KimThanhNguyen1409/sEMG_Gesture_Recognition/BOM_Mua_Linh_Kien_TheGioiIC.xlsx

Sheet: BOM_Mua_Linh_Kien_TheGioiIC.csv
BẢNG DỰ TOÁN & DANH MỤC LINH KIỆN (BOM) - DỰ ÁN MẠCH THU NHẬN TÍN HIỆU SINH HỌC sEMG 3 KÊNH & ESP32-S
 | TỔNG CHỦNG LOẠI |  |  | SỐ LƯỢNG LINH KIỆN (MẠCH CẦN) |  |  | TỔNG CHI PHÍ DỰ TÍNH
STT | Nhóm | Mã hiển thị (Ref) | Tên linh kiện / Trị số | Đóng gói (Footprint) | Số lượng mạch cần | Số lượng nên mua | Đơn giá tham khảo (VNĐ/cái) | Thành tiền dự tính (VNĐ) | Từ khóa tìm kiếm trên Thegioiic.com | Ghi chú kỹ thuật khi chọn mua
1 | IC | U4 U5 U6 U7 U8 | MCP6004-I/SL | SOIC-14 (SOP-14) | 5 | 6 | 8000 |  | MCP6004-I/SL hoặc MCP6004 SOP14 | IC Op-Amp Quad 4 kênh Rail-to-Rail. Mua gói SOP-14 chân dán. (Nếu Thegioiic hết hàng thì Shopee bán vỉ 5 con ~35-50k).
2 | IC | U3 | ESP32-S (hoặc ESP32-WROOM-32) | SMD-38 (ESP32-WROOM-32) | 1 | 1 | 115000 |  | ESP32-S Ai-Thinker hoặc ESP32-WROOM-32 | QUAN TRỌNG: Mạch dùng footprint 38 chân (38 chân viền + 1 pad GND bụng). KHÔNG mua ESP32-S3 41 chân vì lệch footprint.
3 | IC | U1 | TP4056 | SOP-8-EP (ESOP-8) | 1 | 2 | 5700 |  | TP4056 SOP8 | IC sạc pin Li-Po 1A. Chọn loại chân dán SOP-8 có pad tản nhiệt dưới bụng.
4 | IC | U2 | AP2112K-3.3 | SOT-23-5 | 1 | 2 | 4500 |  | AP2112K-3.3 hoặc SOT-23-5 3.3V | LDO 3.3V 600mA cực thấp ồn. (Có thể thay bằng RT9193-33GB hoặc ME6211C33M5G cùng chân SOT-23-5).
5 | Tụ điện | C21 C22 C31 C32 C41 C42 | 100nF (0.1uF / 104) | SMD 1206 | 6 | 10 | 1200 |  | Tụ 1206 100nF hoặc Tụ 1206 0.1uF | QUAN TRỌNG: 6 tụ đầu vào CCIA. Ưu tiên chọn loại gốm C0G / NP0 sai số 5% hoặc 1% (chịu áp >= 25V) để giữ CMRR cân bằng.
6 | Tụ điện | C23 C24 C33 C34 C43 C44 | 2.2nF (mã 222) | SMD 0805 | 6 | 10 | 350 |  | Tụ 0805 2.2nF hoặc Tụ 0805 222 | Tụ hồi tiếp CCIA (G=45.45x). Ưu tiên C0G/NP0 hoặc X7R.
7 | Tụ điện | C16 C25 C35 C45 C63 C64 C65 C66 C67 | 100nF (0.1uF / 104) | SMD 0805 | 9 | 20 | 250 |  | Tụ 0805 100nF hoặc Tụ 0805 0.1uF | Tụ lọc HPF 19.4Hz, tụ lọc V3 của CH340C (C16) và 5 tụ bypass nguồn VDD của 5 con MCP6004.
8 | Tụ điện | C26 C36 C46 | 22nF (mã 223) | SMD 0805 | 3 | 10 | 350 |  | Tụ 0805 22nF hoặc Tụ 0805 223 | Tụ lọc thông thấp Sallen-Key Butterworth 490Hz (C1).
9 | Tụ điện | C27 C37 C47 | 10nF (mã 103) | SMD 0805 | 3 | 10 | 300 |  | Tụ 0805 10nF hoặc Tụ 0805 103 | Tụ lọc thông thấp Sallen-Key Butterworth 490Hz (C2).
10 | Tụ điện | C13 C14 C15 C62 | 1nF (mã 102) | SMD 0805 | 4 | 10 | 300 |  | Tụ 0805 1nF hoặc Tụ 0805 102 | Tụ tích phân DRL (C62) và 3 tụ lọc RC trước ngõ vào ADC của ESP32-S3.
11 | Tụ điện | C1 C2 C4 C10 C60 C61 C68 | 10uF (mã 106) | SMD 0805 | 7 | 15 | 650 |  | Tụ 0805 10uF | Tụ lọc nguồn VBUS, VBAT, +3V3 và lọc ổn định áp chuẩn VREF = 1.65V. Chọn tụ MLCC chịu áp >= 10V (10V/16V/25V).
12 | Tụ điện | C3 | 4.7uF | SMD 0805 | 1 | 5 | 550 |  | Tụ 0805 4.7uF | Tụ ngõ vào LDO AP2112K.
13 | Tụ điện | C12 | 1uF (mã 105) | SMD 0805 | 1 | 5 | 400 |  | Tụ 0805 1uF | Tụ định thì trễ chân EN (Reset) cho ESP32-S3.
14 | Tụ điện | C11 | 0.1uF (100nF) | SMD 0805 | 1 | Dùng chung tép 100nF | 0 |  | Tụ 0805 100nF | Tụ bypass nguồn gần ESP32-S3.
15 | Điện trở | R21 R22 R31 R32 R41 R42 | 150kΩ (mã 154) | SMD 0805 | 6 | 10 | 150 |  | Trở 0805 150k | Trở bảo vệ ngõ vào điện cực người dùng đạt chuẩn an toàn y tế IEC 60601-1 (giới hạn dòng rò < 25uA).
16 | Điện trở | R23 R24 R33 R34 R43 R44 R68 | 10MΩ (mã 106) | SMD 0805 | 7 | 10 | 250 |  | Trở 0805 10M | Trở phân cực ngõ vào Buffer về VREF và trở hồi tiếp DC mạch DRL.
17 | Điện trở | R25 R26 R35 R36 R45 R46 | 22MΩ (mã 226) | SMD 0805 | 6 | 10 | 300 |  | Trở 0805 22M | Trở hồi tiếp DC tầng CCIA định hình tần số cắt dưới 3.3Hz.
18 | Điện trở | R27 R37 R47 | 82kΩ (mã 823) | SMD 0805 | 3 | 10 | 150 |  | Trở 0805 82k | Trở định tần số cắt tầng lọc thông cao HPF 19.4Hz.
19 | Điện trở | R29 R39 R49 | 15kΩ (mã 153) | SMD 0805 | 3 | 10 | 150 |  | Trở 0805 15k | Trở hồi tiếp RF tầng HPF (độ lợi G = 2.5x).
20 | Điện trở | R28 R38 R48 R10 R11 | 10kΩ (mã 103) | SMD 0805 | 5 | 20 | 100 |  | Trở 0805 10k | Trở RG tầng HPF và trở pull-up chân EN, BOOT của ESP32-S3.
21 | Điện trở | R10 R11 R12 R13 R28 R38 R48 | 22kΩ (mã 223) | SMD 0805 | 7 | 20 | 150 |  | Trở 0805 22k | Trở RG tầng HPF, trở pull-up EN/IO0 và trở phân cực cực Base Q1/Q2 mạch Auto-Reset.
22 | Điện trở | R60 R61 R62 R63 R64 R65 R66 R67 | 100kΩ (mã 104) | SMD 0805 | 8 | 20 | 100 |  | Trở 0805 100k | Cầu chia áp VREF 1.65V và 6 trở lấy trung bình sai số chế độ chung vào mạch DRL.
23 | Điện trở | R69 | 390kΩ (mã 394) | SMD 0805 | 1 | 5 | 150 |  | Trở 0805 390k | Trở an toàn bảo vệ ngõ ra DRL nối về cơ thể người.
24 | Điện trở | R1 R2 | 5.1kΩ (mã 512) | SMD 0805 | 2 | 10 | 150 |  | Trở 0805 5.1k | Trở kéo CC1 CC2 cổng Type-C nhận diện nguồn cấp sạc 5V.
25 | Điện trở | R3 | 2.4kΩ (mã 242) | SMD 0805 | 1 | 5 | 150 |  | Trở 0805 2.4k | Trở cấu hình dòng sạc TP4056 (xấp xỉ 500mA an toàn cho pin Li-Po 500-1000mAh).
26 | Điện trở | R4 R5 R6 R17 | 1kΩ (mã 102) | SMD 0805 | 4 | 20 | 100 |  | Trở 0805 1k | Trở hạn dòng cho các đèn LED báo nguồn sạc và trạng thái.
27 | Điện trở | R14 R15 R16 | 100Ω (mã 101) | SMD 0805 | 3 | 10 | 150 |  | Trở 0805 100R | Trở lọc RC trước chân ADC IO4 IO5 IO6 của ESP32-S3.
28 | LED | D1 | Đỏ (RED) | LED 0805 SMD | 1 | 5 | 300 |  | LED 0805 Đỏ | LED báo trạng thái sạc pin (CHRG).
29 | LED | D2 | Xanh lá (GREEN) | LED 0805 SMD | 1 | 5 | 350 |  | LED 0805 Xanh lá | LED báo sạc đầy pin (STDBY).
30 | LED | D3 | Xanh dương (BLUE) | LED 0805 SMD | 1 | 5 | 400 |  | LED 0805 Xanh dương | LED báo nguồn hệ thống 3.3V (PWR).
31 | LED | D4 | Vàng hoặc Xanh | LED 0805 SMD | 1 | 5 | 350 |  | LED 0805 Vàng / Xanh | LED chỉ báo trạng thái chương trình nối chân IO48 ESP32-S3.
32 | Đầu nối | J1 | USB Type-C 16 chân | TYPE-C-31-M-12 SMD | 1 | 2 | 1800 |  | Cổng USB Type C 16 chân SMD | Cổng sạc và nạp code cho ESP32. Chân dán SMD có 4 chấu định vị xuyên lỗ.
33 | Đầu nối | J2 | JST-PH 2-pin đực thẳng | JST-PH-2P 2.0mm Vertical | 1 | 2 | 300 |  | Jack JST PH2.0 2P đực thẳng | Đầu cắm giắc pin Li-Po 3.7V tiêu chuẩn (khoảng cách chân 2.0mm).
34 | Đầu nối | J3 | Header 1x8P 2.54mm đực thẳng | PinHeader 1x08 P=2.54mm | 1 | 1 | 2500 |  | Hàng rào đực 1x40 2.54mm | Hàng rào cắm dây ra 3 cặp điện cực đo và cực DRL VREF.
35 | Nút nhấn | SW2 SW3 | Nút nhấn SMD 2 chân | SW_Push SMD (Alps SKRK 3.9x2.9mm) | 2 | 5 | 800 |  | Nút nhấn SMD 2 chân 3x4 hoặc 3x6 | Nút bấm Reset (EN) và nút Boot (IO0).
36 | Công tắc | SW1 | Công tắc gạt trượt SMD 3 chân | SW_SPDT_PCM12 | 1 | 2 | 1500 |  | Công tắc gạt SMD 3 chân hoặc PCM12 | Công tắc nguồn On/Off từ pin sang mạch.
37 | IC | U9 | CH340C | SOIC-16 (SOP-16) | 1 | 2 | 15000 |  | CH340C SOP-16 (Mã IC36480) | IC chuyển đổi USB sang UART tích hợp sẵn dao động nội 12MHz nạp code cho ESP32-S.
38 | Transistor | Q1 Q2 | MMBT3904 (hoặc S8050 / BC817) | SOT-23 | 2 | 5 | 300 |  | MMBT3904 SOT-23 hoặc BC817 SOT-23 | Transistor NPN dán SOT-23 cho mạch tự động nạp code DTR/RTS (Auto-Reset) điều khiển EN & IO0.
39 | Phụ kiện | Điện cực | Miếng dán điện cực tim/cơ y tế ECG/EMG (nút Snap) | Điện cực dán y tế dùng 1 lần | 7 | 1 | 50000 |  | Điện cực dán nút bấm Snap 3M / Contec hoặc Miếng dán điện cực tim | Bịch 50 miếng dán có sẵn gel dẫn điện (dùng 2 miếng/kênh x 3 kênh + 1 miếng DRL tham chiếu).
40 | Phụ kiện | Cáp nối | Bộ dây cáp kẹp điện cực nút bấm (Snap to Dupont / Jack 3.5) | Dây cáp y tế chuyên dụng | 7 | 1 | 70000 |  | Dây dẫn điện cực ECG Snap to Dupont hoặc Dây điện cực nút bấm 3.5mm | Dây nối từ các nút dán trên bắp tay về trạm cắm Header J3 trên bo mạch (bộ 10 sợi).
 |  |  | TỔNG CHI PHÍ LINH KIỆN DỰ TÍNH (ĐÃ BAO GỒM DỰ PHÒNG) |  |  |  |  |  |  | Ước tính khoảng 410.000 VNĐ cho toàn bộ linh kiện của bo mạch + điện cực & cáp kết nối.

Sheet: Don_Dat_Hang_TheGioiIC
ĐƠN ĐẶT HÀNG & PHIẾU SOẠN HÀNG LINH KIỆN (PURCHASE ORDER)
Dự án: Bo Mạch Đo Điện Sinh Học (sEMG) 3 Kênh & ESP32-S | Mã đơn: PO-TGIC-20261107 | Ngày: 13/11/2026
THÔNG TIN BÊN MUA (KHÁCH HÀNG) |  |  |  |  | THÔNG TIN ĐƠN VỊ CUNG CẤP (BÊN BÁN)
Người đặt: Mạc Quang Khải • Email: khaimac616@gmail.com |  |  |  |  | Nhà cung cấp: CÔNG TY TNHH THƯƠNG MẠI THẾ GIỚI IC
Mục đích: Đặt linh kiện gia công & hàn mẫu bo mạch thử nghiệm |  |  |  |  | Website: Thegioiic.com • Hotline: (028) 3896 8699 • Địa chỉ: TP. Thủ Đức, TP.HCM
 | TỔNG CHỦNG LOẠI |  |  | TỔNG SỐ LƯỢNG ĐẶT |  |  | TỔNG GIÁ TRỊ DỰ TÍNH
STT | Nhóm linh kiện | Tên linh kiện / Thông số kỹ thuật | Đóng gói (Footprint) | Số lượng đặt | ĐVT | Từ khóa tìm kiếm trên Thegioiic.com | Đơn giá dự kiến (VNĐ) | Thành tiền dự kiến (VNĐ) | Kiểm tra kho (Pick List)
1 | IC | MCP6004-I/SL (U4, U5, U6, U7, U8) - Op-Amp Quad 4 kênh Rail-to-Rail | SOIC-14 (SOP-14) | 6 | Cái | MCP6004-I/SL hoặc MCP6004 SOP14 | 8000 ₫ |  | FALSE
2 | IC | ESP32-S (U3) - Module Wi-Fi/BLE SMD 38 chân (Ai-Thinker hoặc ESP32-WROOM-32) | SMD-38 (ESP32-WROOM-32) | 1 | Cái | ESP32-S Ai-Thinker hoặc ESP32-WROOM-32 | 115000 ₫ |  | FALSE
3 | IC | TP4056 (U1) - IC sạc pin Li-Po 1A | SOP-8-EP (ESOP-8 có pad tản nhiệt) | 2 | Cái | TP4056 SOP8 | 5700 ₫ |  | FALSE
4 | IC | AP2112K-3.3 (U2) - LDO 3.3V 600mA Low-noise | SOT-23-5 | 2 | Cái | AP2112K-3.3 hoặc SOT-23-5 3.3V | 4500 ₫ |  | FALSE
5 | Tụ điện | 100nF (0.1uF / 104) - C0G/NP0 sai số thấp (C21, C22, C31, C32, C41, C42) | SMD 1206 | 10 | Cái | Tụ 1206 100nF hoặc Tụ 1206 0.1uF | 1200 ₫ |  | FALSE
6 | Tụ điện | 2.2nF (mã 222) - Tụ hồi tiếp CCIA C0G/X7R (C23, C24, C33, C34, C43, C44) | SMD 0805 | 10 | Cái | Tụ 0805 2.2nF hoặc Tụ 0805 222 | 350 ₫ |  | FALSE
7 | Tụ điện | 100nF (0.1uF / 104) 50V - Tụ lọc HPF & Bypass (C25, C35, C45, C63-C67) | SMD 0805 | 20 | Cái | Tụ 0805 100nF hoặc Tụ 0805 0.1uF | 250 ₫ |  | FALSE
8 | Tụ điện | 22nF (mã 223) - Tụ lọc Butterworth 490Hz (C26, C36, C46) | SMD 0805 | 10 | Cái | Tụ 0805 22nF hoặc Tụ 0805 223 | 350 ₫ |  | FALSE
9 | Tụ điện | 10nF (mã 103) - Tụ lọc Butterworth 490Hz (C27, C37, C47) | SMD 0805 | 10 | Cái | Tụ 0805 10nF hoặc Tụ 0805 103 | 300 ₫ |  | FALSE
10 | Tụ điện | 1nF (mã 102) - Tụ tích phân DRL & Lọc ADC (C13, C14, C15, C62) | SMD 0805 | 10 | Cái | Tụ 0805 1nF hoặc Tụ 0805 102 | 300 ₫ |  | FALSE
11 | Tụ điện | 10uF (mã 106) >= 10V - Lọc nguồn & Áp chuẩn VREF (C1, C2, C4, C10, C60, C61, C68) | SMD 0805 | 15 | Cái | Tụ 0805 10uF | 650 ₫ |  | FALSE
12 | Tụ điện | 4.7uF - Tụ ngõ vào LDO AP2112K (C3) | SMD 0805 | 5 | Cái | Tụ 0805 4.7uF | 550 ₫ |  | FALSE
13 | Tụ điện | 1uF (mã 105) - Tụ trễ chân Reset EN (C12) | SMD 0805 | 5 | Cái | Tụ 0805 1uF | 400 ₫ |  | FALSE
14 | Tụ điện | 0.1uF (100nF) - Tụ bypass gần ESP32-S3 (C11) | SMD 0805 | 0 | Cái | Tụ 0805 100nF (Dùng chung từ tép STT 7) | 0 ₫ |  | FALSE
15 | Điện trở | 150kΩ (mã 154) - Bảo vệ ngõ vào chuẩn y tế IEC 60601-1 (R21, R22, R31, R32, R41, R42) | SMD 0805 | 10 | Cái | Trở 0805 150k | 150 ₫ |  | FALSE
16 | Điện trở | 10MΩ (mã 106) - Phân cực ngõ vào & Hồi tiếp DRL (R23, R24, R33, R34, R43, R44, R68) | SMD 0805 | 10 | Cái | Trở 0805 10M | 250 ₫ |  | FALSE
17 | Điện trở | 22MΩ (mã 226) - Hồi tiếp DC tầng CCIA 3.3Hz (R25, R26, R35, R36, R45, R46) | SMD 0805 | 10 | Cái | Trở 0805 22M | 300 ₫ |  | FALSE
18 | Điện trở | 82kΩ (mã 823) - Định tần cắt HPF 19.4Hz (R27, R37, R47) | SMD 0805 | 10 | Cái | Trở 0805 82k | 150 ₫ |  | FALSE
19 | Điện trở | 15kΩ (mã 153) - Hồi tiếp RF tầng HPF G=2.5x (R29, R39, R49) | SMD 0805 | 10 | Cái | Trở 0805 15k | 150 ₫ |  | FALSE
20 | Điện trở | 10kΩ (mã 103) - Trở RG tầng HPF & Pull-up EN/BOOT (R28, R38, R48, R10, R11) | SMD 0805 | 20 | Cái | Trở 0805 10k | 100 ₫ |  | FALSE
21 | Điện trở | 22kΩ (mã 223) - Mạch lọc Butterworth 490Hz (R30, R40, R50, R51, R52, R53) | SMD 0805 | 10 | Cái | Trở 0805 22k | 150 ₫ |  | FALSE
22 | Điện trở | 100kΩ (mã 104) - Cầu chia áp VREF 1.65V & Mạch DRL (R60-R67) | SMD 0805 | 20 | Cái | Trở 0805 100k | 100 ₫ |  | FALSE
23 | Điện trở | 390kΩ (mã 394) - Trở an toàn ngõ ra DRL nối cơ thể (R69) | SMD 0805 | 5 | Cái | Trở 0805 390k | 150 ₫ |  | FALSE
24 | Điện trở | 5.1kΩ (mã 512) - Kéo chân CC1, CC2 cổng Type-C (R1, R2) | SMD 0805 | 10 | Cái | Trở 0805 5.1k | 150 ₫ |  | FALSE
25 | Điện trở | 2.4kΩ (mã 242) - Định dòng sạc 500mA cho TP4056 (R3) | SMD 0805 | 5 | Cái | Trở 0805 2.4k | 150 ₫ |  | FALSE
26 | Điện trở | 1kΩ (mã 102) - Hạn dòng cho các LED báo hiệu (R4, R5, R6, R17) | SMD 0805 | 20 | Cái | Trở 0805 1k | 100 ₫ |  | FALSE
27 | Điện trở | 100Ω (mã 101) - Mạch lọc RC ngõ vào ADC ESP32 (R14, R15, R16) | SMD 0805 | 10 | Cái | Trở 0805 100R | 150 ₫ |  | FALSE
28 | LED | Đỏ (RED) - Báo trạng thái sạc pin CHRG (D1) | LED 0805 SMD | 5 | Cái | LED 0805 Đỏ | 300 ₫ |  | FALSE
29 | LED | Xanh lá (GREEN) - Báo sạc đầy pin STDBY (D2) | LED 0805 SMD | 5 | Cái | LED 0805 Xanh lá | 350 ₫ |  | FALSE
30 | LED | Xanh dương (BLUE) - Báo nguồn hệ thống 3.3V PWR (D3) | LED 0805 SMD | 5 | Cái | LED 0805 Xanh dương | 400 ₫ |  | FALSE
31 | LED | Vàng hoặc Xanh - Chỉ báo trạng thái GPIO48 (D4) | LED 0805 SMD | 5 | Cái | LED 0805 Vàng / Xanh | 350 ₫ |  | FALSE
32 | Đầu nối | USB Type-C 16 chân SMD sạc & nạp code (J1) | TYPE-C-31-M-12 SMD | 2 | Cái | Cổng USB Type C 16 chân SMD | 1800 ₫ |  | FALSE
33 | Đầu nối | JST-PH 2-pin đực thẳng 2.0mm cắm pin Li-Po (J2) | JST-PH-2P 2.0mm Vertical | 2 | Cái | Jack JST PH2.0 2P đực thẳng | 300 ₫ |  | FALSE
34 | Đầu nối | Header 1x8P 2.54mm đực thẳng cắm điện cực (J3) | PinHeader 1x08 P=2.54mm | 1 | Cái | Hàng rào đực 1x40 2.54mm | 2500 ₫ |  | FALSE
35 | Nút nhấn | Nút nhấn SMD 2 chân Reset (EN) & Boot (IO0) (SW2, SW3) | SW_Push SMD (3.9x2.9mm / 3x4mm) | 5 | Cái | Nút nhấn SMD 2 chân 3x4 hoặc 3x6 | 800 ₫ |  | FALSE
36 | Công tắc | Công tắc gạt trượt SMD 3 chân nguồn On/Off (SW1) | SW_SPDT_PCM12 | 2 | Cái | Công tắc gạt SMD 3 chân hoặc PCM12 | 1500 ₫ |  | FALSE
37 | IC | CH340C (U9) - IC cầu chuyển đổi USB sang UART nạp code ESP32-S | SOIC-16 (SOP-16) | 2 | Cái | CH340C SOP-16 (Mã IC36480) | 15000 ₫ |  | FALSE
38 | Transistor | MMBT3904 (Q1, Q2) - Transistor NPN dán SOT-23 mạch Auto-Reset DTR/RTS | SOT-23 | 5 | Cái | MMBT3904 SOT-23 hoặc BC817 SOT-23 | 300 ₫ |  | FALSE
39 | Phụ kiện | Miếng dán điện cực y tế ECG/EMG có sẵn gel (bịch 50 cái) | Điện cực dán Snap Button | 1 | Bịch | Miếng dán điện cực tim ECG/EMG hoặc Nút dán điện cực Snap | 50000 ₫ |  | FALSE
40 | Phụ kiện | Dây cáp bấm điện cực nút Snap ra đầu Dupont cắm bo mạch (bộ 10 sợi) | Dây cáp y tế chuyên dụng | 1 | Bộ | Dây dẫn điện cực ECG Snap to Dupont hoặc Dây điện cực nút bấm 3.5mm | 70000 ₫ |  | FALSE
TỔNG CỘNG GIÁ TRỊ ĐƠN HÀNG DỰ TÍNH (VNĐ)

Sheet: Bang_Hoi_Gia_TheGioiIC
STT | Tên linh kiện / Thông số kỹ thuật | Đóng gói (Footprint) | Số lượng cần mua | Link sản phẩm (Thegioiic.com)
1 | MCP6004-I/SL hoặc MCP6004 SOP14 - Op-Amp Quad Rail-to-Rail | SOIC-14 (SOP-14) | 6 | MCP6004-I/SL IC OPAMP General Purpose Amplifier 4 Circuit 1MHz, 14-SOIC (https://www.thegioiic.com/mcp6004-i-sl-ic-opamp-general-purpose-amplifier-4-circuit-1mhz-14-soic)
~~2~~ | ~~ESP32-S (hoặc ESP32-WROOM-32 38 chân dán)~~ | ~~SMD-38 (ESP32-WROOM-32)~~ | ~~1~~ | ~~https://www.thegioiic.com/esp32-s-ai-thinker-module-wifi-bluetooth-4mb-flash~~ (https://www.thegioiic.com/esp32-s3-wroom-1-n16r8-module-wifi-bluetooth-16mb-flash-8mb-psram-2-4ghz)
3 | TP4056 - IC sạc pin Li-Po 1A | SOP-8-EP (ESOP-8 có pad tản nhiệt) | 2 | TP4056 IC Sạc Pin Li-Ion 1 Cell, 1 A, 4.2V 8-SOP (https://www.thegioiic.com/tp4056-ic-sac-pin-li-ion-1-cell-1-a-4-2v-8-sop)
4 | AP2112K-3.3 - LDO 3.3V 600mA Low-noise | SOT-23-5 | 2 | RT9193-33GB IC Ổn Áp 3.3V 300mA (https://www.thegioiic.com/rt9193-33gb-ic-on-ap-3-3v-300ma)
5 | 100nF (0.1uF / 104) - C0G/NP0 | SMD 1206 | 10 | Tụ Gốm 1206 100nF (0.1uF) 50V (https://www.thegioiic.com/tu-gom-1206-100nf-0-1uf-50v)
6 | 2.2nF (mã 222) - C0G/X7R | SMD 0805 | 10 | Tụ Gốm 0805 2.2nF 50V (https://www.thegioiic.com/tu-gom-0805-2-2nf-50v)
7 | 100nF (0.1uF / 104) 50V | SMD 0805 | 20 | Tụ Gốm 0805 100nF (0.1uF) 50V (https://www.thegioiic.com/tu-gom-0805-100nf-0-1uf-50v)
8 | 22nF (mã 223) | SMD 0805 | 10 | Tụ Gốm 0805 22nF 50V (https://www.thegioiic.com/tu-gom-0805-22nf-50v)
9 | 10nF (mã 103) | SMD 0805 | 10 | Tụ Gốm 0805 10nF 50V (https://www.thegioiic.com/tu-gom-0805-10nf-50v)
10 | 1nF (mã 102) | SMD 0805 | 10 | Tụ Gốm 0805 1nF 50V (https://www.thegioiic.com/tu-gom-0805-1nf-50v)
11 | 10uF (mã 106) >= 10V | SMD 0805 | 15 | Tụ Gốm 0805 10uF 25V (https://www.thegioiic.com/tu-gom-0805-10uf-25v)
12 | 4.7uF | SMD 0805 | 5 | Tụ Gốm 0805 4.7uF 50V (https://www.thegioiic.com/tu-gom-0805-4-7uf-50v)
13 | 1uF (mã 105) | SMD 0805 | 5 | Tụ Gốm 0805 1uF 50V (https://www.thegioiic.com/tu-gom-0805-1uf-50v)
14 | 0.1uF (100nF) | SMD 0805 | 0 | Tụ Gốm 0805 100nF (0.1uF) 50V (https://www.thegioiic.com/tu-gom-0805-100nf-0-1uf-50v)
15 | 150kΩ (mã 154) | SMD 0805 | 10 | Sách Điện Trở 0805 1% 170 Loại, Mỗi Loại 50 Con, Từ 0-10 MOhm (https://www.thegioiic.com/sach-dien-tro-0805-1-170-loai-moi-loai-50-con-tu-0-10-mohm)
16 | 10MΩ (mã 106) | SMD 0805 | 10 | Sách Điện Trở 0805 1% 170 Loại, Mỗi Loại 50 Con, Từ 0-10 MOhm (https://www.thegioiic.com/sach-dien-tro-0805-1-170-loai-moi-loai-50-con-tu-0-10-mohm)
17 | 22MΩ (mã 226) | SMD 0805 | 10 | Điện Trở Dán SMD (https://www.thegioiic.com/san-pham/dien-tro-dan-smd)
18 | 82kΩ (mã 823) | SMD 0805 | 10 | Sách Điện Trở 0805 1% 170 Loại, Mỗi Loại 50 Con, Từ 0-10 MOhm (https://www.thegioiic.com/sach-dien-tro-0805-1-170-loai-moi-loai-50-con-tu-0-10-mohm)
19 | 15kΩ (mã 153) | SMD 0805 | 10 | Điện Trở 12 KOhm 0805 1% (https://www.thegioiic.com/dien-tro-12-kohm-0805-1-)
20 | 10kΩ (mã 103) | SMD 0805 | 20 | Điện Trở 10 KOhm 0805 5% (https://www.thegioiic.com/dien-tro-10-kohm-0805-5-)
21 | 22kΩ (mã 223) | SMD 0805 | 10 | Sách Điện Trở 0805 1% 170 Loại, Mỗi Loại 50 Con, Từ 0-10 MOhm (https://www.thegioiic.com/sach-dien-tro-0805-1-170-loai-moi-loai-50-con-tu-0-10-mohm)
22 | 100kΩ (mã 104) | SMD 0805 | 20 | Điện Trở 100 KOhm 0805 1% (https://www.thegioiic.com/dien-tro-100-kohm-0805-1-)
23 | 390kΩ (mã 394) | SMD 0805 | 5 | Sách Điện Trở 0805 1% 170 Loại, Mỗi Loại 50 Con, Từ 0-10 MOhm (https://www.thegioiic.com/sach-dien-tro-0805-1-170-loai-moi-loai-50-con-tu-0-10-mohm)
24 | 5.1kΩ (mã 512) | SMD 0805 | 10 | Sách Điện Trở 0805 1% 170 Loại, Mỗi Loại 50 Con, Từ 0-10 MOhm (https://www.thegioiic.com/sach-dien-tro-0805-1-170-loai-moi-loai-50-con-tu-0-10-mohm)
25 | 2.4kΩ (mã 242) | SMD 0805 | 5 | Điện Trở 3.6 KOhm 0805 5% (https://www.thegioiic.com/dien-tro-3-6-kohm-0805-5-)
26 | 1kΩ (mã 102) | SMD 0805 | 20 | Điện Trở 1 KOhm 0805 1% (https://www.thegioiic.com/dien-tro-1-kohm-0805-1-)
27 | 100Ω (mã 101) | SMD 0805 | 10 | Điện Trở 100 Ohm 0805 5% (https://www.thegioiic.com/dien-tro-100-ohm-0805-5-)
28 | Đỏ (RED) | LED 0805 SMD | 5 | LED Đỏ 0805 Dán SMD Trong Suốt (https://www.thegioiic.com/led-do-0805-dan-smd-trong-suot)
29 | Xanh lá (GREEN) | LED 0805 SMD | 5 | LED Xanh Lá 0805 Dán SMD Trong Suốt (https://www.thegioiic.com/led-xanh-la-0805-dan-smd-trong-suot)
30 | Xanh dương (BLUE) | LED 0805 SMD | 5 | LED Xanh Dương 0805 Dán SMD Trong Suốt (https://www.thegioiic.com/led-xanh-duong-0805-dan-smd-trong-suot)
31 | Vàng hoặc Xanh | LED 0805 SMD | 5 | LED 2 Màu Vàng, Xanh 0805 Dán SMD Trong Suốt (https://www.thegioiic.com/led-2-mau-vang-xanh-0805-dan-smd-trong-suot)
32 | USB Type-C 16 chân SMD | TYPE-C-31-M-12 SMD | 2 | Cổng USB Cái 3.1 Type C 16 Chân Thẳng Dán SMD (https://www.thegioiic.com/cong-usb-cai-3-1-type-c-16-chan-thang-dan-smd)
33 | JST-PH 2-pin đực thẳng 2.0mm | JST-PH-2P 2.0mm Vertical | 2 | Đầu PH2.0mm 2 Chân Dán SMD Nằm Ngang (https://www.thegioiic.com/dau-ph2-0mm-2-chan-dan-smd-nam-ngang)
34 | Header 1x8P 2.54mm đực thẳng | PinHeader 1x08 P=2.54mm | 1 | Hàng Rào Đực Đơn 2.54mm 40 Chân 1 Hàng Cao 11.2mm Xuyên Lỗ Màu Đen (https://www.thegioiic.com/hang-rao-duc-don-2-54mm-40-chan-1-hang-cao-11-2mm-xuyen-lo-mau-den)
35 | Nút nhấn SMD 2 chân | SW_Push SMD (3.9x2.9mm / 3x4mm) | 5 | Nút Nhấn 3x4mm Cao 2.5mm 2 Chân SMD (https://www.thegioiic.com/nut-nhan-3x4mm-cao-2-5mm-2-chan-smd)
36 | Công tắc gạt trượt SMD 3 chân | SW_SPDT_PCM12 | 2 | SS-12D10 Công Tắc Trượt 3 Chân Xuyên Lỗ ON-OFF 1P2T 0.5A (https://www.thegioiic.com/ss-12d10-cong-tac-truot-3-chan-xuyen-lo-on-off-1p2t-0-5a)
37 | CH340C SOP-16 - IC chuyển đổi USB sang UART có dao động nội | SOIC-16 (SOP-16) | 2 | https://www.thegioiic.com/ch340c-ic-chuyen-doi-usb-sang-uart-sop-16
38 | MMBT3904 (hoặc BC817 / S8050) - Transistor NPN SOT-23 | SOT-23 | 5 | https://www.thegioiic.com/mmbt3904-transistor-npn-40v-0-2a-sot-23
39 | Miếng dán điện cực tim/cơ y tế ECG/EMG (nút Snap) | Điện cực dán y tế dùng 1 lần (bịch 50 cái) | 1 | Miếng dán điện cực tim ECG/EMG hoặc Nút dán điện cực Snap (Shopee / Thiết bị y tế)
40 | Bộ dây cáp kẹp điện cực nút bấm (Snap to Dupont / Jack 3.5mm) | Dây cáp đo điện tim/cơ chuyên dụng (10 sợi) | 1 | Dây dẫn điện cực ECG Snap to Dupont hoặc Dây điện cực nút bấm 3.5mm
