KimThanhNguyen1409/sEMG_Gesture_Recognition/AFE_EMG_3ch.asc

C_BULK: cap; 10u
C_DEC: cap; 100n
C_DRL: cap; 1n
C_FN1: cap; 2.2n
C_FN2: cap; 2.2n
C_FN3: cap; 2.2n
C_FP1: cap; 2.2n
C_FP2: cap; 2.2n
C_FP3: cap; 2.2n
C_HP1: cap; 100n
C_HP2: cap; 100n
C_HP3: cap; 100n
C_INN1: cap; 100n
C_INN2: cap; 100n
C_INN3: cap; 100n
C_INP1: cap; 100n
C_INP2: cap; 100n
C_INP3: cap; 100n
C_L11: cap; 22n
C_L12: cap; 22n
C_L13: cap; 22n
C_L21: cap; 10n
C_L22: cap; 10n
C_L23: cap; 10n
C_REF: cap; 10u
C_VREF: cap; 10u
R_A1: res; 100k
R_A2: res; 100k
R_A3: res; 100k
R_A4: res; 100k
R_A5: res; 100k
R_A6: res; 100k
R_BN1: res; 10Meg
R_BN2: res; 10Meg
R_BN3: res; 10Meg
R_BP1: res; 10Meg
R_BP2: res; 10Meg
R_BP3: res; 10Meg
R_DRLF: res; 10Meg
R_DRLO: res; 390k
R_F1: res; 15k
R_F2: res; 15k
R_F3: res; 15k
R_FN1: res; 22Meg
R_FN2: res; 22Meg
R_FN3: res; 22Meg
R_FP1: res; 22Meg
R_FP2: res; 22Meg
R_FP3: res; 22Meg
R_G1: res; 10k
R_G2: res; 10k
R_G3: res; 10k
R_HP1: res; 82k
R_HP2: res; 82k
R_HP3: res; 82k
R_INN1: res; 150k
R_INN2: res; 150k
R_INN3: res; 150k
R_INP1: res; 150k
R_INP2: res; 150k
R_INP3: res; 150k
R_L11: res; 22k
R_L12: res; 22k
R_L13: res; 22k
R_L21: res; 22k
R_L22: res; 22k
R_L23: res; 22k
R_REF1: res; 100k
R_REF2: res; 100k
U1A: AD8605
U1B: AD8605
U1C: AD8605
U1N: AD8605
U1P: AD8605
U2A: AD8605
U2B: AD8605
U2C: AD8605
U2N: AD8605
U2P: AD8605
U3A: AD8605
U3B: AD8605
U3C: AD8605
U3N: AD8605
U3P: AD8605
U_DRL: AD8605
U_REF: AD8605
V_BAT: voltage; 3.3
V_CM1: voltage; SINE(0 0.2 50)
V_CM2: voltage; SINE(0 0.2 50)
V_CM3: voltage; SINE(0 0.2 50)
V_EN1: voltage; SINE(0 0.0005 150 0 0 180) AC 0.5 180
V_EN2: voltage; SINE(0 0.00025 90 0 0 180) AC 0.5 180
V_EN3: voltage; SINE(0 0.0001 220 0 0 180) AC 0.5 180
V_EP1: voltage; SINE(0.3 0.0005 150) AC 0.5
V_EP2: voltage; SINE(0.3 0.00025 90) AC 0.5
V_EP3: voltage; SINE(0.3 0.0001 220) AC 0.5
Named nets: VCC, 0, VREF, BUFN1, BUFP1, BUFN2, BUFP2, BUFN3, BUFP3, DRL, BODY1, EN1, EP1, S1_1, S2_1, OUT1, BODY2, EN2, EP2, S1_2, S2_2, OUT2, BODY3, EN3, EP3, S1_3, S2_3, OUT3
NGUON 3.3V (pin + LDO)  &  VREF = VCC/2
Decoupling: sat chan VCC moi IC
DRL: trung binh 6 buffer -> tich phan dao -> 390k -> dien cuc REF (giam nhieu 50Hz tren co the)
-> dien cuc REF (390k han dong an toan)
=== KENH 1 ===
Mo hinh dien cuc
Buffer tro khang vao cao
Tang 1: CCIA  G = Cin/Cf = 45
Tang 2: HPF 19Hz + G = 2.5
Tang 3: Sallen-Key LPF 490Hz
-> ADC1
=== KENH 2 ===
Mo hinh dien cuc
Buffer tro khang vao cao
Tang 1: CCIA  G = Cin/Cf = 45
Tang 2: HPF 19Hz + G = 2.5
Tang 3: Sallen-Key LPF 490Hz
-> ADC2
=== KENH 3 ===
Mo hinh dien cuc
Buffer tro khang vao cao
Tang 1: CCIA  G = Cin/Cf = 45
Tang 2: HPF 19Hz + G = 2.5
Tang 3: Sallen-Key LPF 490Hz
-> ADC3
.tran 0 1.5 0 10u
.ac dec 100 0.1 10k
Xem V(out1..3) tu 0.8s. Doi .tran <-> .ac: chuot phai len dong lenh -> Comment / SPICE directive
