KimThanhNguyen1409/sEMG_Gesture_Recognition/hardware/EMG_Armband_3CH.kicad_pcb

## KiCad design hardware/EMG_Armband_3CH.kicad_pcb (2026-11-12)

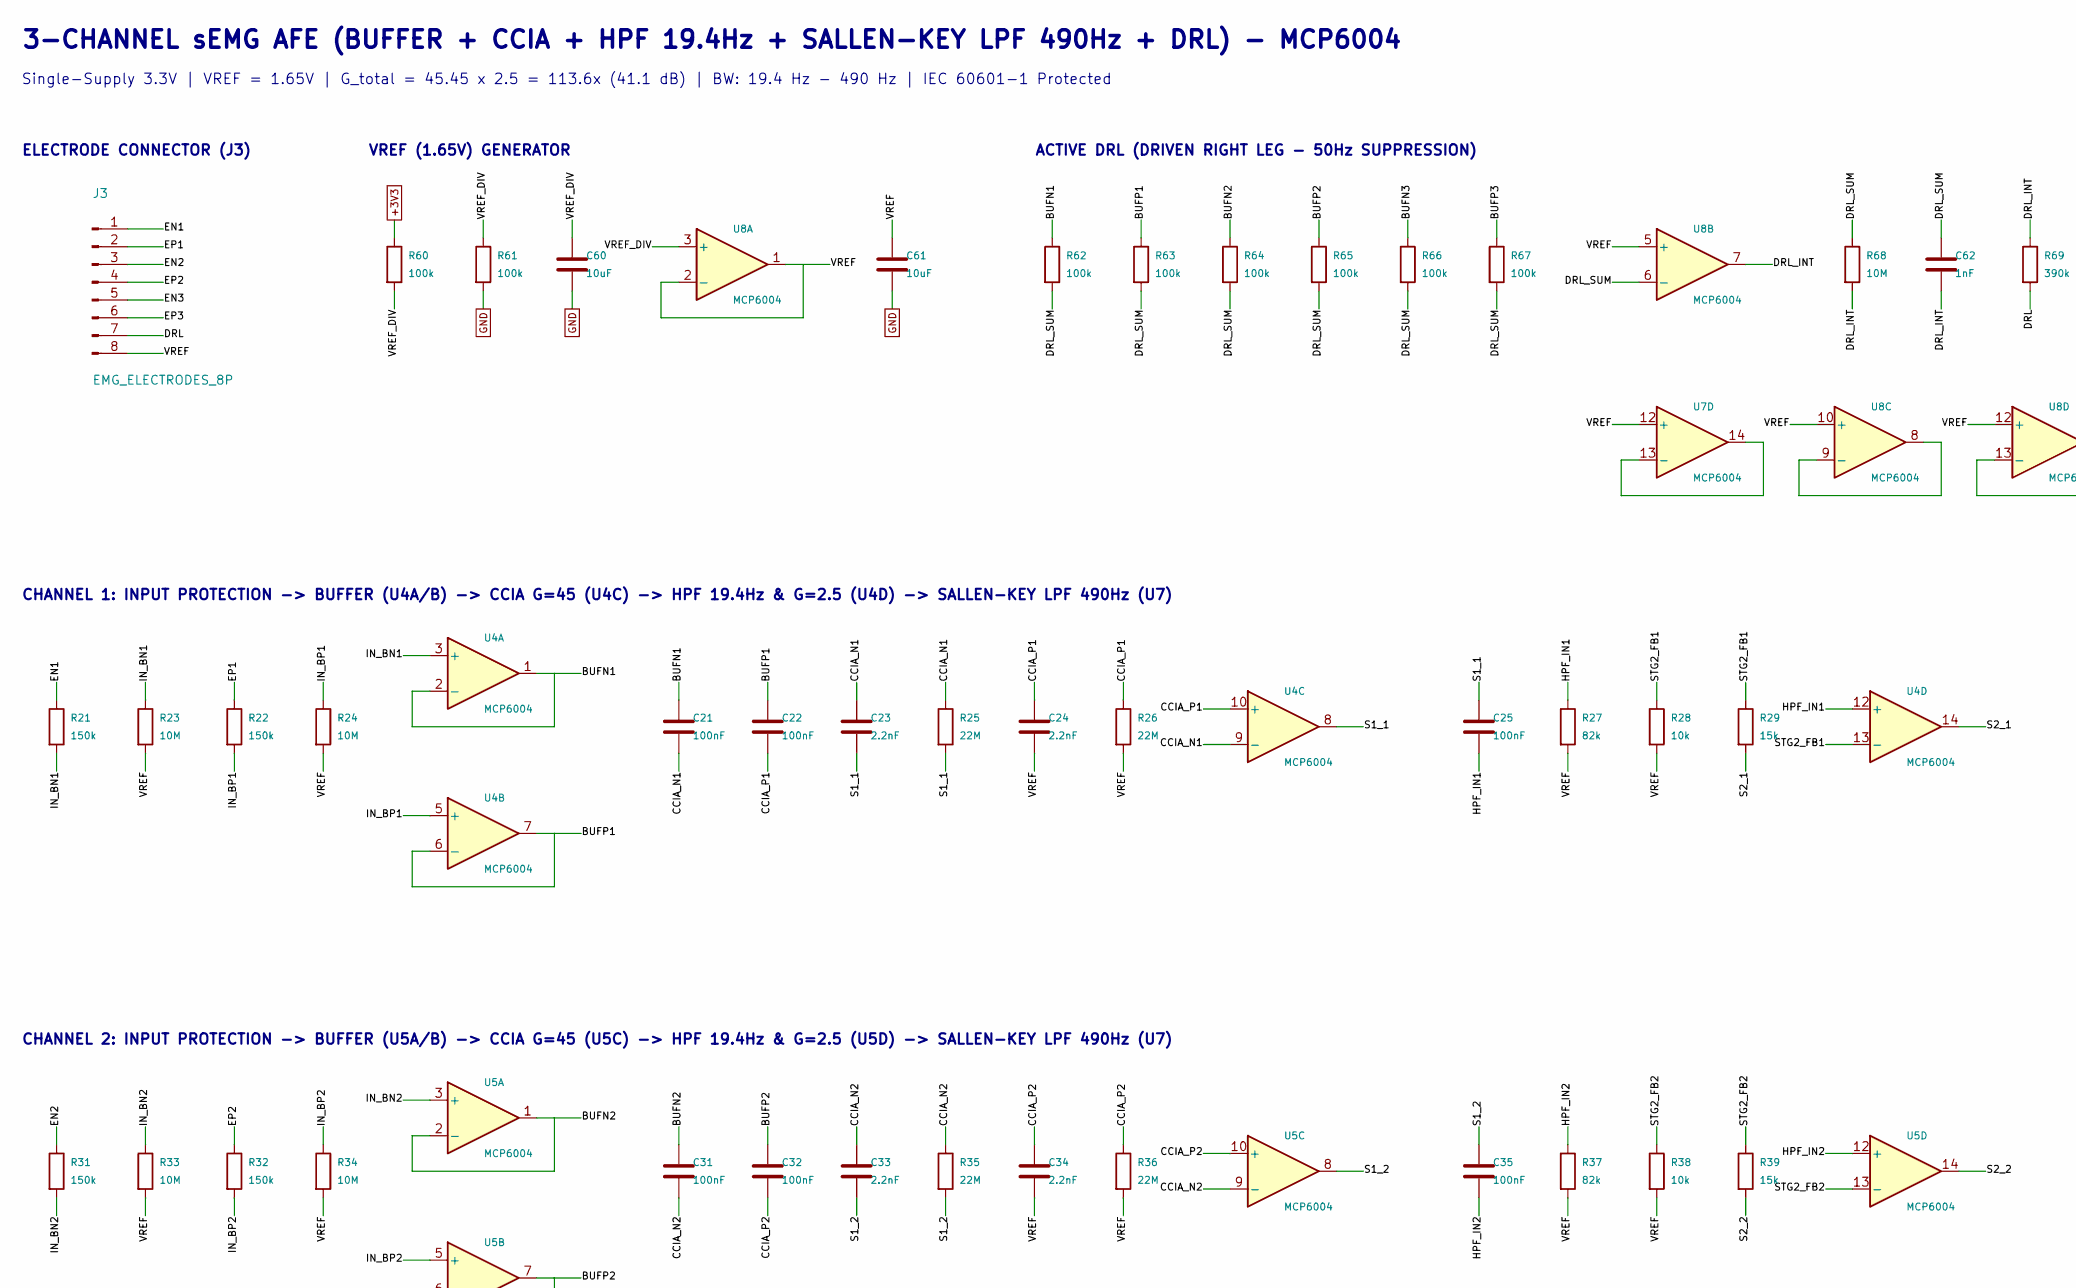
[picture p1: schematic EMG_Armband_3CH.kicad_sch, part in row 1, column 1]

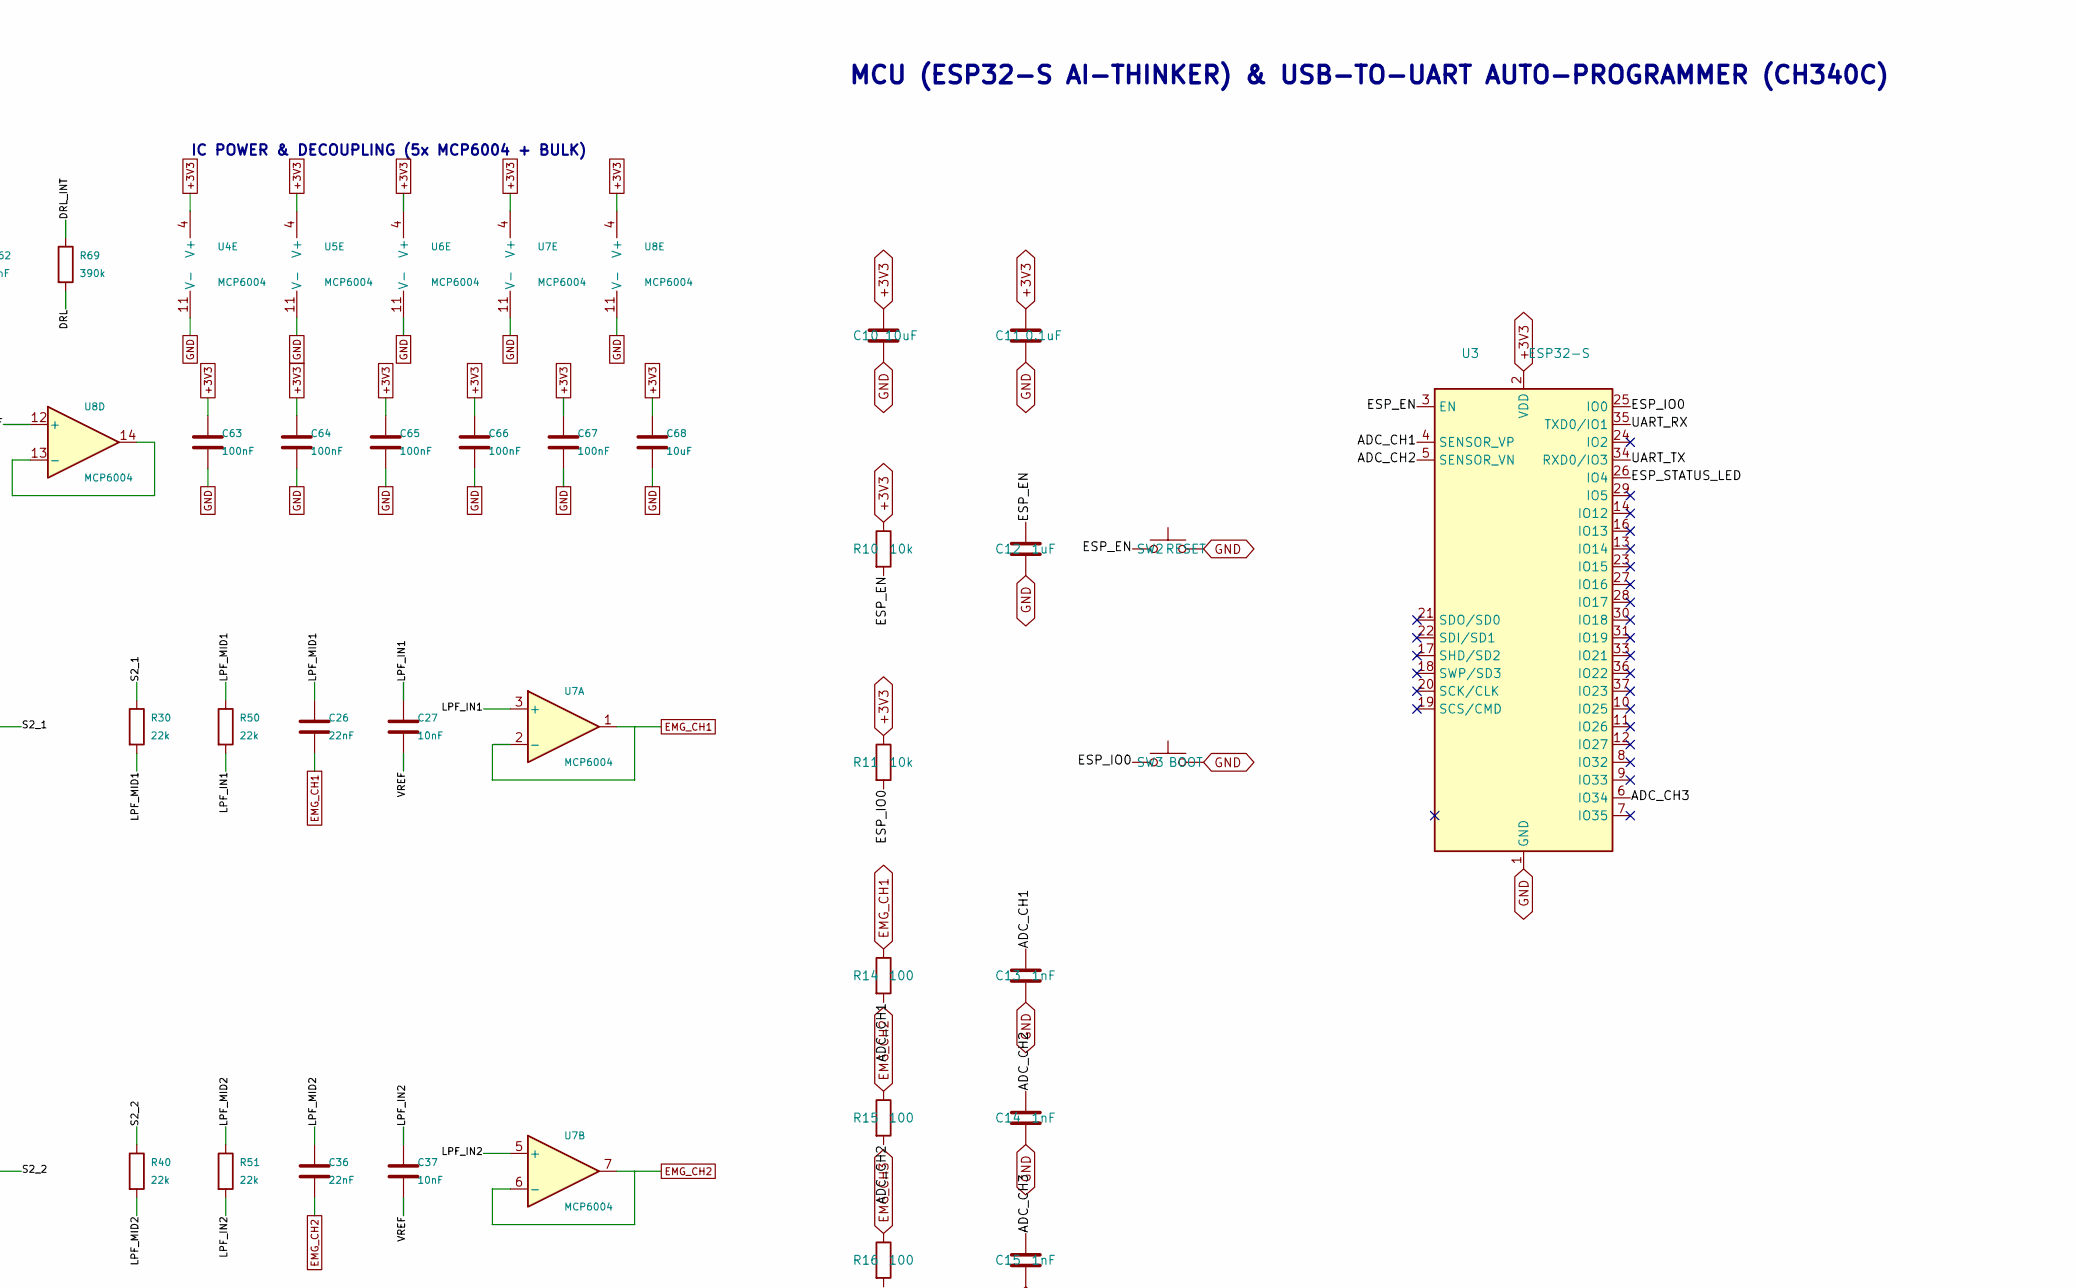
[picture p2: schematic EMG_Armband_3CH.kicad_sch, part in row 1, column 2]

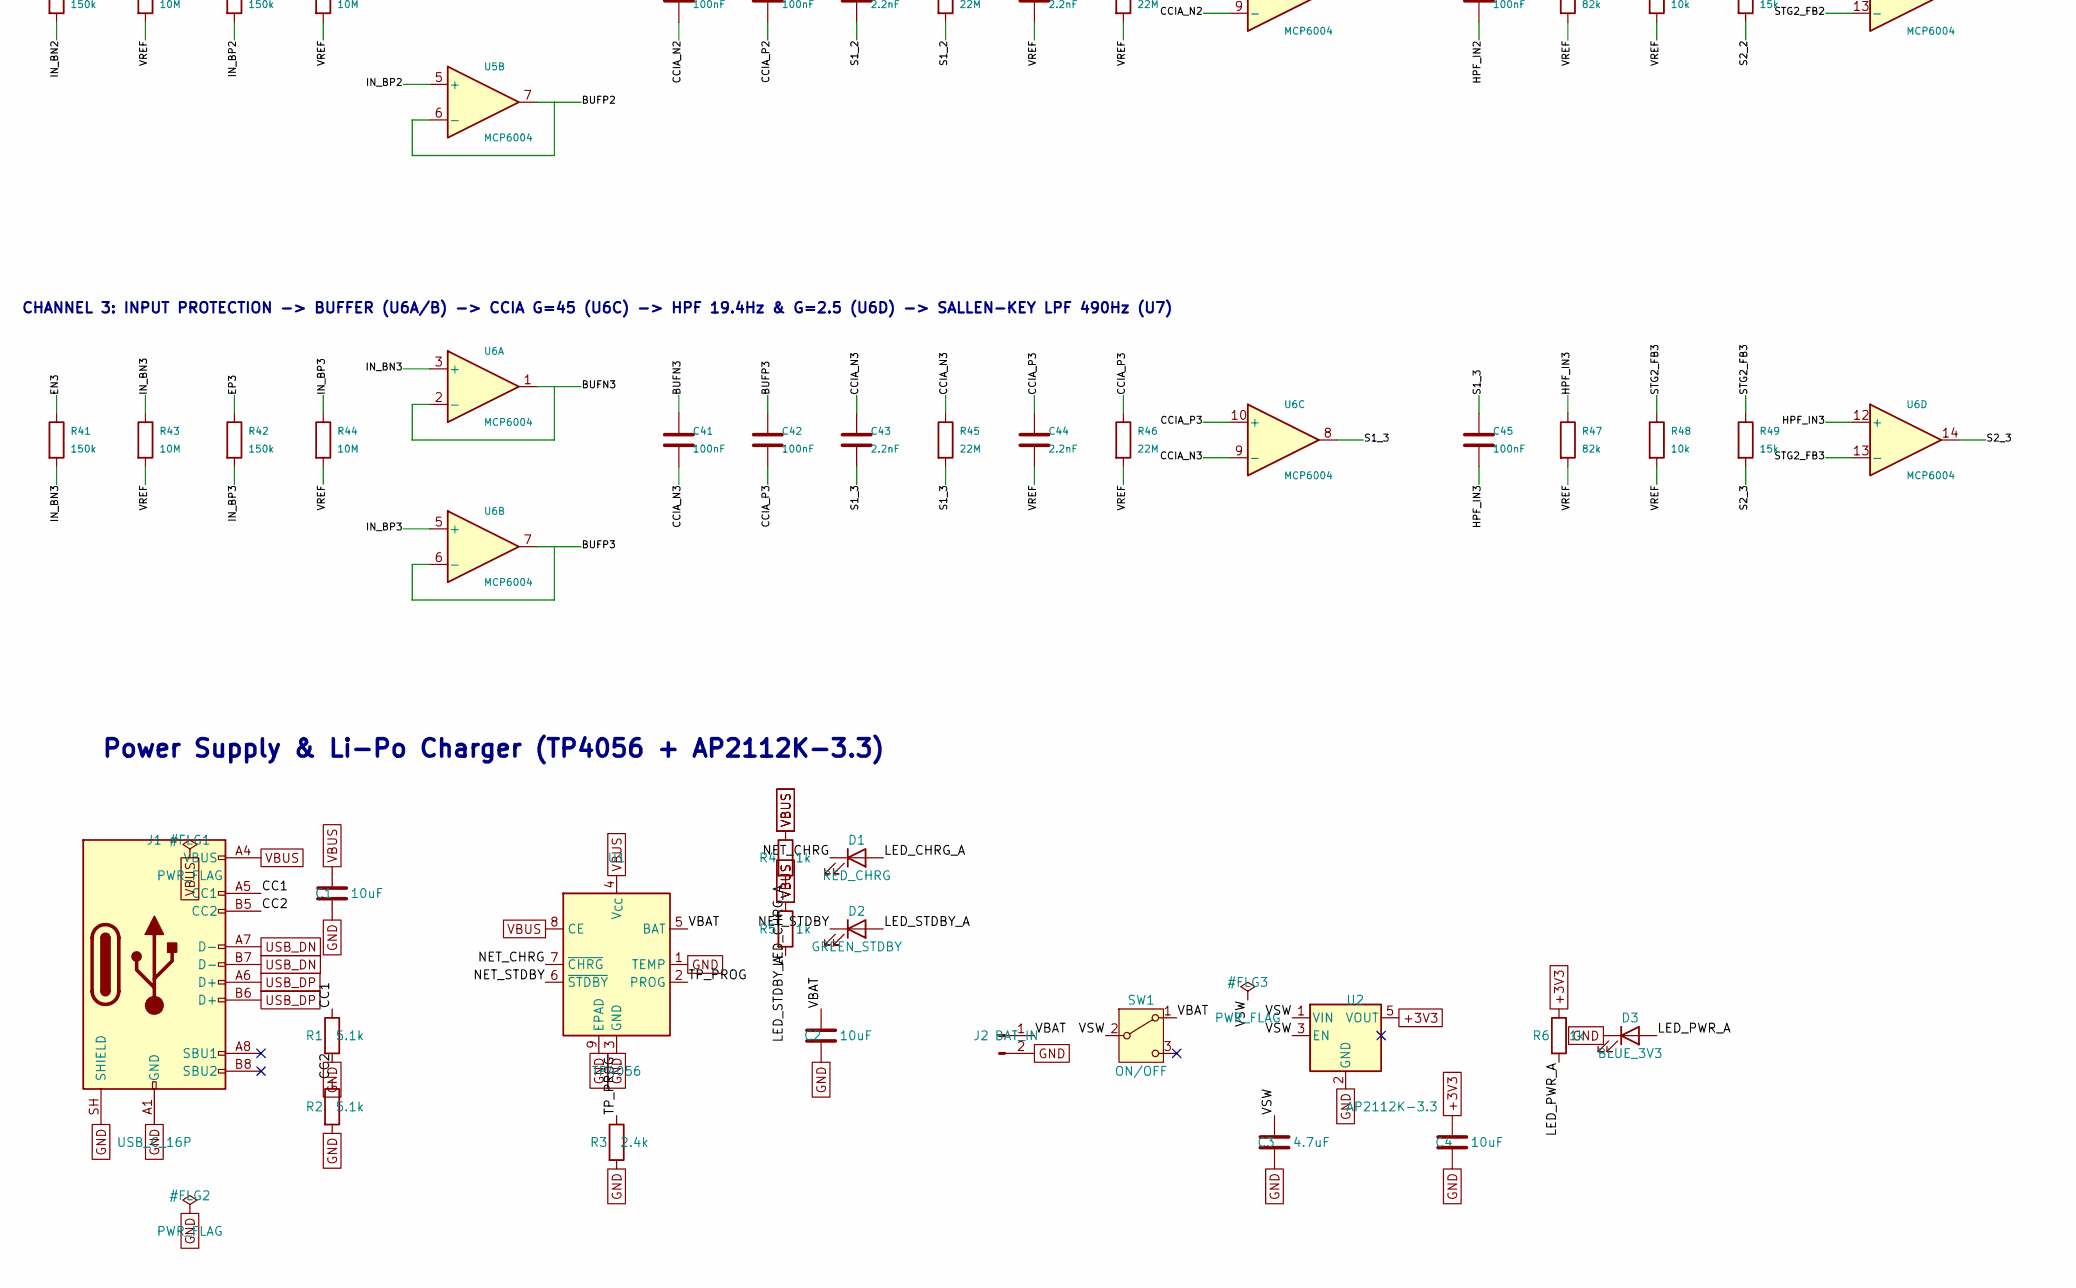
[picture p3: schematic EMG_Armband_3CH.kicad_sch, part in row 2, column 1]

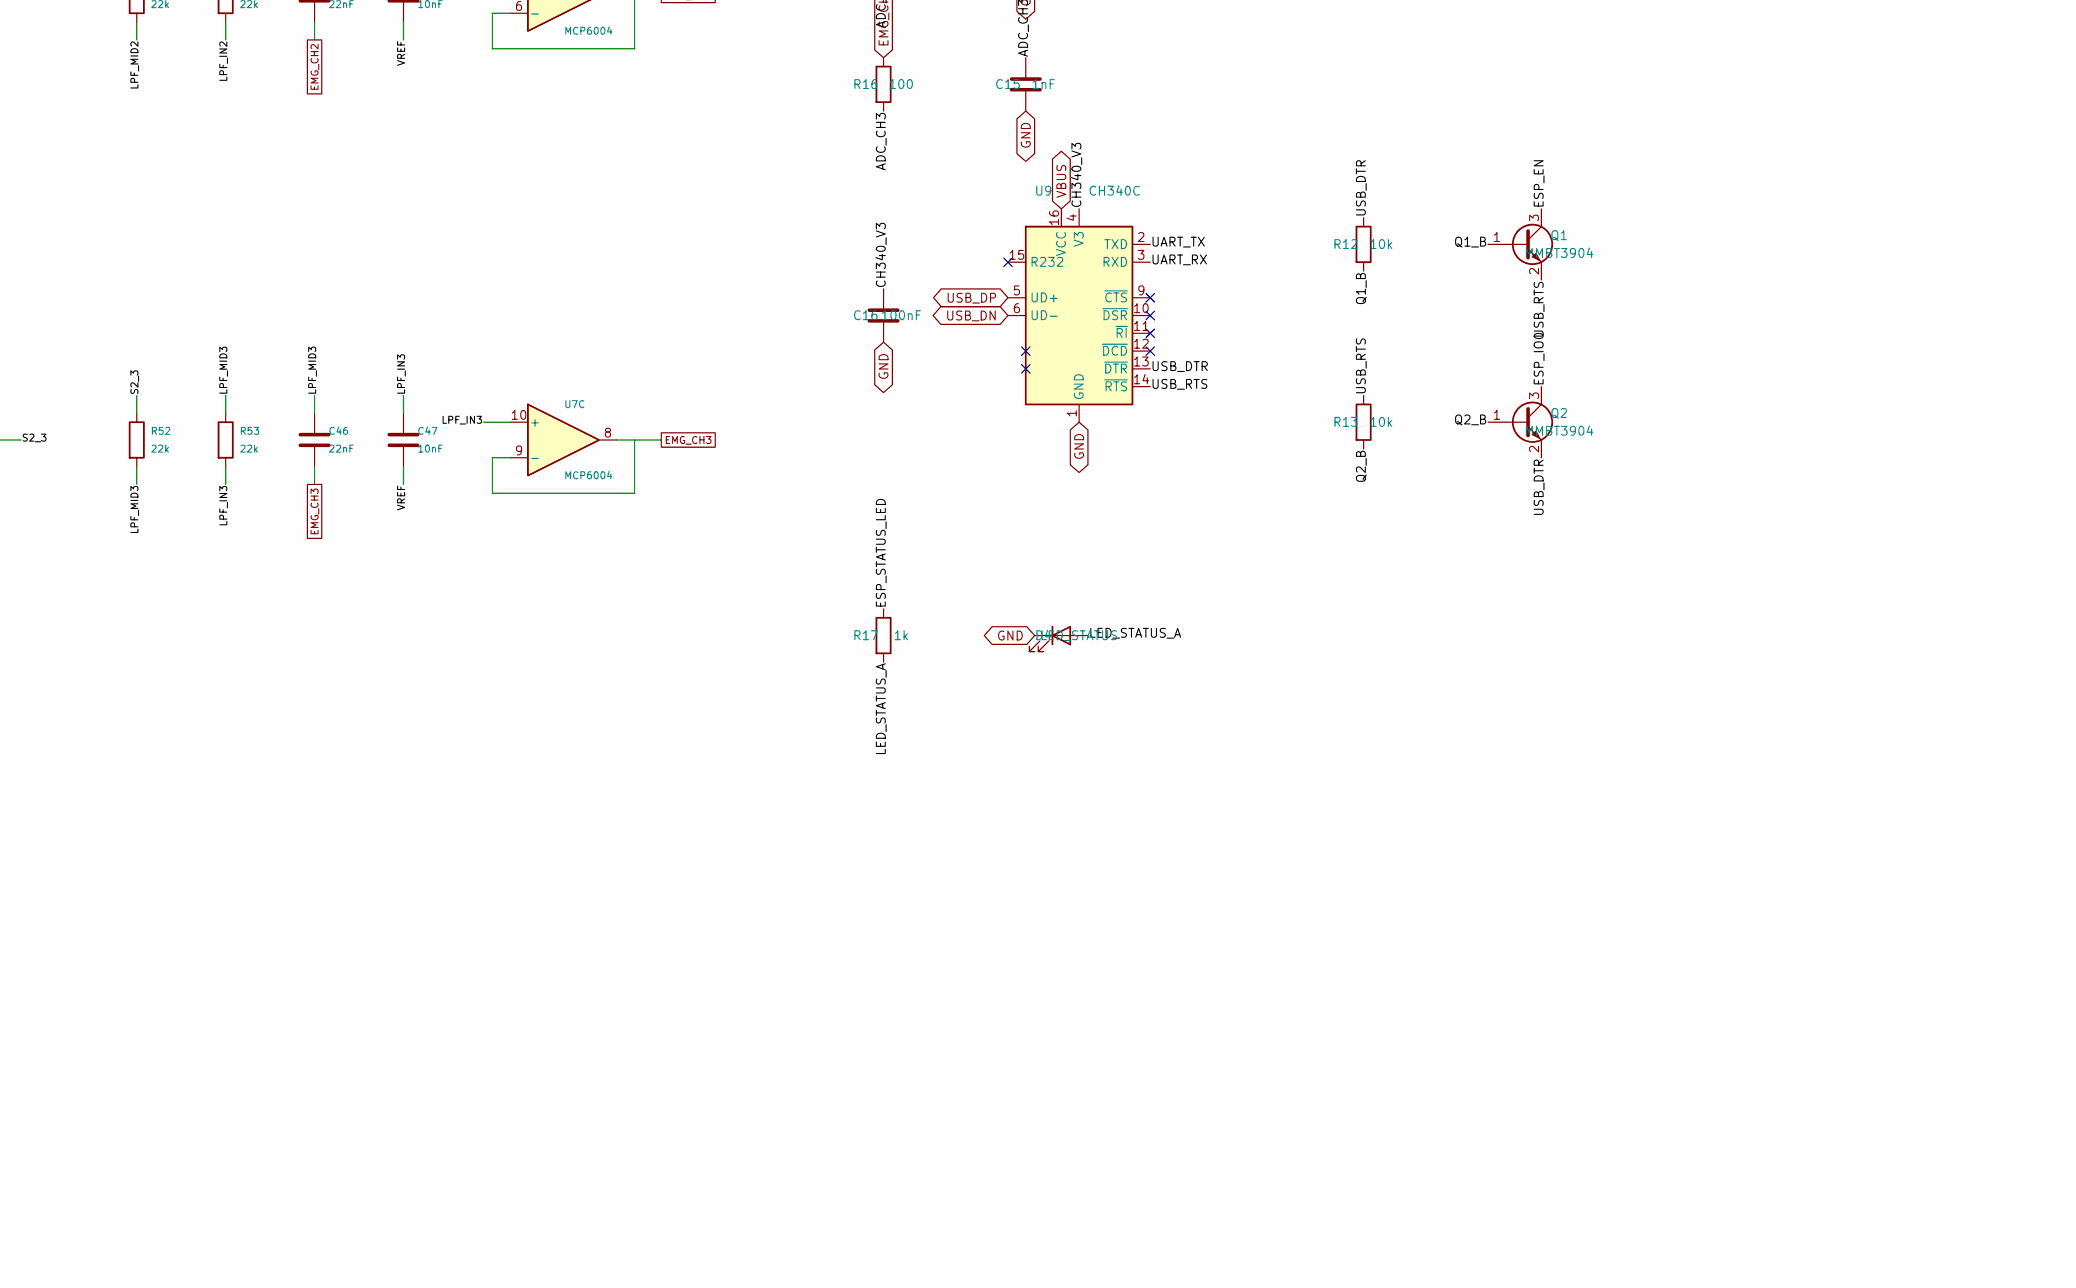
[picture p4: schematic EMG_Armband_3CH.kicad_sch, part in row 2, column 2]

Parts:
C1, C2, C4, C10, C60, C61, C68: 10uF; C_0805_2012Metric
C3: 4.7uF; C_0805_2012Metric
C11: 0.1uF; C_0805_2012Metric
C12: 1uF; C_0805_2012Metric
C13, C14, C15, C62: 1nF; C_0805_2012Metric
C16, C25, C35, C45, C63, C64, C65, C66, C67: 100nF; C_0805_2012Metric
C21, C22, C31, C32, C41, C42: 100nF; C_1206_3216Metric
C23, C24, C33, C34, C43, C44: 2.2nF; C_0805_2012Metric
C26, C36, C46: 22nF; C_0805_2012Metric
C27, C37, C47: 10nF; C_0805_2012Metric
D1: RED_CHRG; LED_0805_2012Metric
D2: GREEN_STDBY; LED_0805_2012Metric
D3: BLUE_3V3; LED_0805_2012Metric
D4: LED_STATUS; LED_0805_2012Metric
J1: USB_C_16P; USB_C_Receptacle_HRO_TYPE-C-31-M-12
J2: BAT_IN; JST_PH_B2B-PH-K_1x02_P2.00mm_Vertical
J3: EMG_ELECTRODES_8P; PinHeader_1x08_P2.54mm_Vertical
Q1, Q2: MMBT3904; SOT-23
R1, R2: 5.1k; R_0805_2012Metric
R3: 2.4k; R_0805_2012Metric
R4, R5, R6, R17: 1k; R_0805_2012Metric
R10, R11, R12, R13, R28, R38, R48: 10k; R_0805_2012Metric
R14, R15, R16: 100; R_0805_2012Metric
R21, R22, R31, R32, R41, R42: 150k; R_0805_2012Metric
R23, R24, R33, R34, R43, R44, R68: 10M; R_0805_2012Metric
R25, R26, R35, R36, R45, R46: 22M; R_0805_2012Metric
R27, R37, R47: 82k; R_0805_2012Metric
R29, R39, R49: 15k; R_0805_2012Metric
R30, R40, R50, R51, R52, R53: 22k; R_0805_2012Metric
R60, R61, R62, R63, R64, R65, R66, R67: 100k; R_0805_2012Metric
R69: 390k; R_0805_2012Metric
SW1: ON/OFF; SW_SPDT_PCM12
SW2: RESET; SW_Push_SPST_NO_Alps_SKRK
SW3: BOOT; SW_Push_SPST_NO_Alps_SKRK
U1: TP4056; SOIC-8-1EP_3.9x4.9mm_P1.27mm_EP2.41x3.3mm
U2: AP2112K-3.3; SOT-23-5
U3: ESP32-S; ESP32-WROOM-32
U4, U5, U6, U7, U8: MCP6004; SOIC-14_3.9x8.7mm_P1.27mm
U9: CH340C; SOIC-16_3.9x9.9mm_P1.27mm

Connections:
+3V3: C4.1, C10.1, C11.1, C63.1, C64.1, C65.1, C66.1, C67.1, C68.1, R6.1, R10.1, R11.1, R60.1, U2.5 (VOUT), U3.2 (VDD), U4.4 (V+), U5.4 (V+), U6.4 (V+), U7.4 (V+), U8.4 (V+)
/ADC_CH1: C13.1, R14.2, U3.4 (SENSOR_VP)
/ADC_CH2: C14.1, R15.2, U3.5 (SENSOR_VN)
/ADC_CH3: C15.1, R16.2, U3.6 (IO34)
/BUFN1: C21.1, R62.1, U4.1, U4.2 (-)
/BUFN2: C31.1, R64.1, U5.1, U5.2 (-)
/BUFN3: C41.1, R66.1, U6.1, U6.2 (-)
/BUFP1: C22.1, R63.1, U4.6 (-), U4.7
/BUFP2: C32.1, R65.1, U5.6 (-), U5.7
/BUFP3: C42.1, R67.1, U6.6 (-), U6.7
/CC1: J1.A5 (CC1), R1.1
/CC2: J1.B5 (CC2), R2.1
/CCIA_N1: C21.2, C23.1, R25.1, U4.9 (-)
/CCIA_N2: C31.2, C33.1, R35.1, U5.9 (-)
/CCIA_N3: C41.2, C43.1, R45.1, U6.9 (-)
/CCIA_P1: C22.2, C24.1, R26.1, U4.10 (+)
/CCIA_P2: C32.2, C34.1, R36.1, U5.10 (+)
/CCIA_P3: C42.2, C44.1, R46.1, U6.10 (+)
/CH340_V3: C16.1, U9.4 (V3)
/DRL: J3.7, R69.2
/DRL_INT: C62.2, R68.2, R69.1, U8.7
/DRL_SUM: C62.1, R62.2, R63.2, R64.2, R65.2, R66.2, R67.2, R68.1, U8.6 (-)
/EN1: J3.1, R21.1
/EN2: J3.3, R31.1
/EN3: J3.5, R41.1
/EP1: J3.2, R22.1
/EP2: J3.4, R32.1
/EP3: J3.6, R42.1
/ESP_EN: C12.1, Q1.3 (C), R10.2, SW2.1, U3.3 (EN)
/ESP_IO0: Q2.3 (C), R11.2, SW3.1, U3.25 (IO0)
/ESP_STATUS_LED: R17.1, U3.26 (IO4)
/HPF_IN1: C25.2, R27.1, U4.12 (+)
/HPF_IN2: C35.2, R37.1, U5.12 (+)
/HPF_IN3: C45.2, R47.1, U6.12 (+)
/IN_BN1: R21.2, R23.1, U4.3 (+)
/IN_BN2: R31.2, R33.1, U5.3 (+)
/IN_BN3: R41.2, R43.1, U6.3 (+)
/IN_BP1: R22.2, R24.1, U4.5 (+)
/IN_BP2: R32.2, R34.1, U5.5 (+)
/IN_BP3: R42.2, R44.1, U6.5 (+)
/LED_CHRG_A: D1.2 (A), R4.2
/LED_PWR_A: D3.2 (A), R6.2
/LED_STATUS_A: D4.2 (A), R17.2
/LED_STDBY_A: D2.2 (A), R5.2
/LPF_IN1: C27.1, R50.2, U7.3 (+)
/LPF_IN2: C37.1, R51.2, U7.5 (+)
/LPF_IN3: C47.1, R53.2, U7.10 (+)
/LPF_MID1: C26.1, R30.2, R50.1
/LPF_MID2: C36.1, R40.2, R51.1
/LPF_MID3: C46.1, R52.2, R53.1
/NET_CHRG: D1.1 (K), U1.7 (~CHRG)
/NET_STDBY: D2.1 (K), U1.6 (~STDBY)
/Q1_B: Q1.1 (B), R12.2
/Q2_B: Q2.1 (B), R13.2
/S1_1: C23.2, C25.1, R25.2, U4.8
/S1_2: C33.2, C35.1, R35.2, U5.8
/S1_3: C43.2, C45.1, R45.2, U6.8
/S2_1: R29.2, R30.1, U4.14
/S2_2: R39.2, R40.1, U5.14
/S2_3: R49.2, R52.1, U6.14
/STG2_FB1: R28.1, R29.1, U4.13 (-)
/STG2_FB2: R38.1, R39.1, U5.13 (-)
/STG2_FB3: R48.1, R49.1, U6.13 (-)
/TP_PROG: R3.1, U1.2 (PROG)
/UART_RX: U3.35 (TXD0/IO1), U9.3 (RXD)
/UART_TX: U3.34 (RXD0/IO3), U9.2 (TXD)
/USB_DTR: Q2.2 (E), R12.1, U9.13 (~DTR)
/USB_RTS: Q1.2 (E), R13.1, U9.14 (~RTS)
/VBAT: C2.1, J2.1, SW1.1 (A), U1.5 (BAT)
/VREF: C24.2, C27.2, C34.2, C37.2, C44.2, C47.2, C61.1, J3.8, R23.2, R24.2, R26.2, R27.2, R28.2, R33.2, R34.2, R36.2, R37.2, R38.2, R43.2, R44.2, R46.2, R47.2, R48.2, U7.12 (+), U8.1, U8.2 (-), U8.5 (+), U8.10 (+), U8.12 (+)
/VREF_DIV: C60.1, R60.2, R61.1, U8.3 (+)
/VSW: C3.1, SW1.2 (B), U2.1 (VIN), U2.3 (EN)
EMG_CH1: C26.2, R14.1, U7.1, U7.2 (-)
EMG_CH2: C36.2, R15.1, U7.6 (-), U7.7
EMG_CH3: C46.2, R16.1, U7.8, U7.9 (-)
GND: C1.2, C2.2, C3.2, C4.2, C10.2, C11.2, C12.2, C13.2, C14.2, C15.2, C16.2, C60.2, C61.2, C63.2, C64.2, C65.2, C66.2, C67.2, C68.2, D3.1 (K), D4.1 (K), J1.A1 (GND), J1.A12 (GND), J1.B1 (GND), J1.B12 (GND), J1.SH (SHIELD), J2.2, R1.2, R2.2, R3.2, R61.2, SW2.2, SW3.2, U1.1 (TEMP), U1.3 (GND), U1.9 (EPAD), U2.2 (GND), U3.1 (GND), U3.15 (GND), U3.38 (GND), U3.39 (GND), U4.11 (V-), U5.11 (V-), U6.11 (V-), U7.11 (V-), U8.11 (V-), U9.1 (GND)
unnamed: U7.13 (-), U7.14
unnamed: U8.8, U8.9 (-)
unnamed: U8.13 (-), U8.14
USB_DN: J1.A7 (D-), J1.B7 (D-), U9.6 (UD-)
USB_DP: J1.A6 (D+), J1.B6 (D+), U9.5 (UD+)
VBUS: C1.1, J1.A4 (VBUS), J1.A9 (VBUS), J1.B4 (VBUS), J1.B9 (VBUS), R4.1, R5.1, U1.4 (V_{CC}), U1.8 (CE), U9.16 (VCC)

Notes on the sheet:
3-CHANNEL sEMG AFE (BUFFER + CCIA + HPF 19.4Hz + SALLEN-KEY LPF 490Hz + DRL) - MCP6004
Single-Supply 3.3V | VREF = 1.65V | G_total = 45.45 x 2.5 = 113.6x (41.1 dB) | BW: 19.4 Hz - 490 Hz | IEC 60601-1 Protected
ELECTRODE CONNECTOR (J3)
VREF (1.65V) GENERATOR
ACTIVE DRL (DRIVEN RIGHT LEG - 50Hz SUPPRESSION)
IC POWER & DECOUPLING (5x MCP6004 + BULK)
CHANNEL 1: INPUT PROTECTION -> BUFFER (U4A/B) -> CCIA G=45 (U4C) -> HPF 19.4Hz & G=2.5 (U4D) -> SALLEN-KEY LPF 490Hz (U7)
CHANNEL 2: INPUT PROTECTION -> BUFFER (U5A/B) -> CCIA G=45 (U5C) -> HPF 19.4Hz & G=2.5 (U5D) -> SALLEN-KEY LPF 490Hz (U7)
CHANNEL 3: INPUT PROTECTION -> BUFFER (U6A/B) -> CCIA G=45 (U6C) -> HPF 19.4Hz & G=2.5 (U6D) -> SALLEN-KEY LPF 490Hz (U7)
MCU (ESP32-S AI-THINKER) & USB-TO-UART AUTO-PROGRAMMER (CH340C)
Power Supply & Li-Po Charger (TP4056 + AP2112K-3.3)

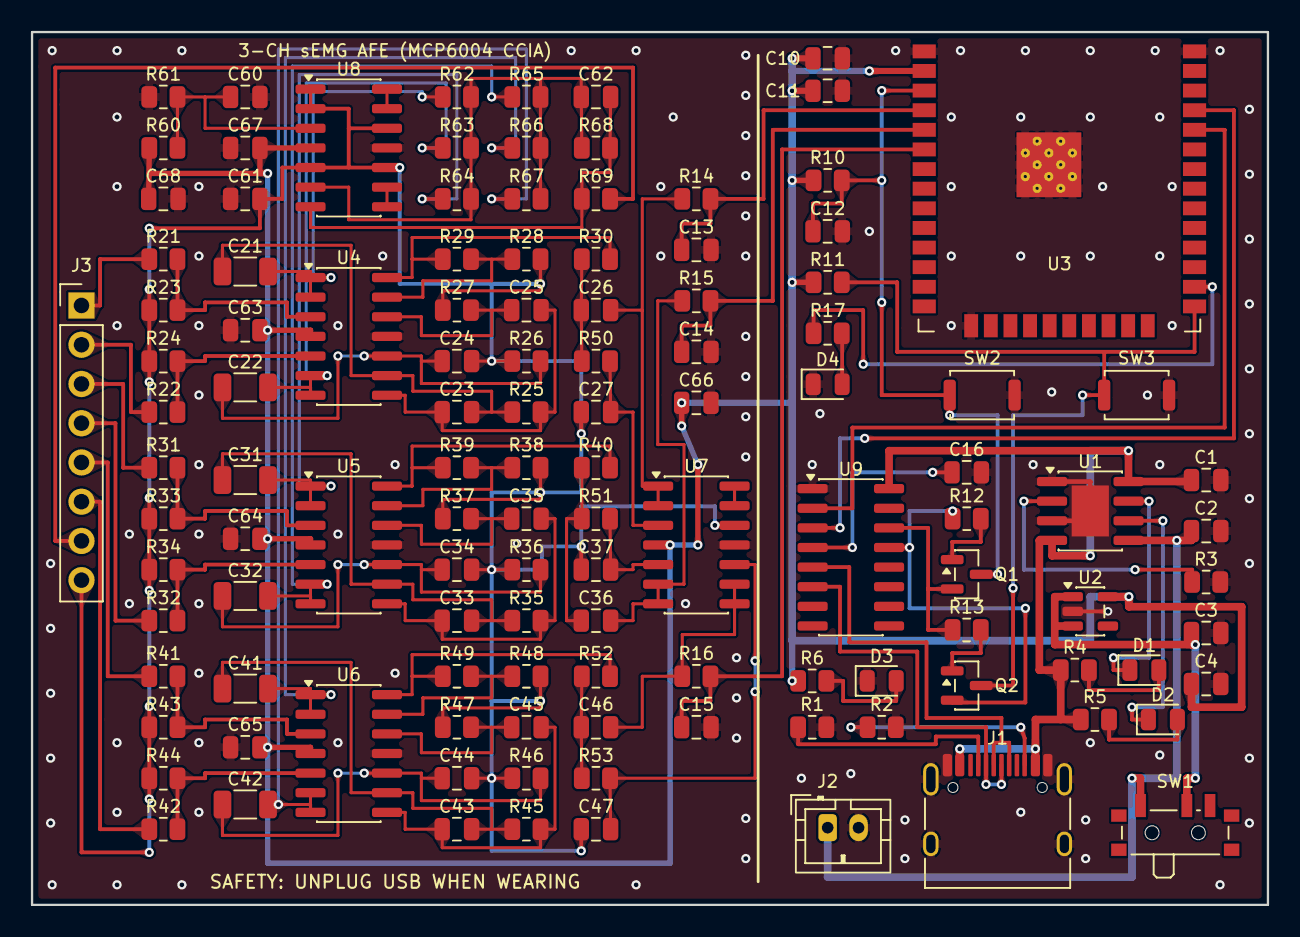
[picture p5: board EMG_Armband_3CH.kicad_pcb from above]

Board: 2 copper layers, 80.0 x 56.5 mm, 119 parts (0 on the bottom side), 82 nets.
