KimThanhNguyen1409/sEMG_Gesture_Recognition/(commit log)

2026-11-01 feat(hardware): complete 3-channel sEMG AFE design with MCP6004 and ESP32-S3
    [AFE_3CH_AD8232.kicad_sch, EMG_Armband_3CH.kicad_pcb, EMG_Armband_3CH.kicad_sch, MCU_ESP32.kicad_sch, Power_Supply.kicad_sch]
2026-11-05 feat(pcb): complete 113-component layout placement and pass DRC checks
    - Synchronize 113 components and 108 nets from hierarchical schematics
    - Complete 2-zone structured PCB placement (Analog AFE & Digital MCU/Power)
    - Clean up silkscreen overlaps and adjust USB-C/switch clearance
    - Pass KiCad 10 DRC with 0 violations and 0 schematic parity errors
    - Add visual PCB preview EMG_Armband_3CH-PCB.svg
    [EMG_Armband_3CH.kicad_pcb]
2026-11-12 feat(pcb): complete Stage 1 AFE routing and netclass rules (0 DRC errors)
    [EMG_Armband_3CH.kicad_pcb]
2026-11-12 chore(cleanup): remove obsolete sub-sheets, AD8232 schematics, and temp images
    [AFE_3CH_AD8232.kicad_sch, EMG_Armband_3CH.kicad_sch, MCU_ESP32.kicad_sch, Power_Supply.kicad_sch]
2026-11-12 feat(hardware): complete stage 2 routing for MCU, USB-UART and power management
    - Route USB Type-C (J1) CC pins and VBUS distribution
    - Route TP4056 (U1) LiPo charger and status LEDs (D1, D2)
    - Route AP2112K-3.3 (U2) LDO and +3V3 power rail to MCU, AFE tie point and LED (D3)
    - Route CH340C (U9) USB-to-UART bridge and auto-reset circuit (Q1, Q2)
    - Route ESP32-S (U3) EN, BOOT, status LED (D4), and UART lines
    - Pass DRC with 0 violations and 0 schematic parity issues (47 GND pads pending copper pour in stage 3)
    [EMG_Armband_3CH.kicad_pcb]
2026-11-12 feat(hardware): complete stage 3 with dual-layer GND pour, stitching vias and teardrops
    - Add F.Cu and solid B.Cu ground copper pour zones (Faraday shield)
    - Place 103 GND stitching and thermal vias (guard fence, perimeter ring, U1.9 thermal pad)
    - Enable native teardrops on vias, PTH pads and passive SMD components
    - Pass ERC and DRC with 0 errors, 0 warnings, 0 unconnected items, and 0 parity issues
    [EMG_Armband_3CH.kicad_pcb]
2026-11-13 docs(bom): update Excel and CSV BOM with CH340C, MMBT3904, electrodes, snap cables and correct ESP32 footprint
    [BOM_Mua_Linh_Kien_TheGioiIC.csv, BOM_Mua_Linh_Kien_TheGioiIC.xlsx]
